unterland-space/badge/Firmware/README.md

# Unterland Badge Firmware

## How To Build
1. Open this folder in VS Code
1. "Just use PlatformIO"

## How To Upload
1. Connect badge to PC (either USB-C port is fine)
1. Turn off power switch (SW3, beside right USB port)
1. Hold right button
1. Turn on power switch
1. => Badge is now in USB ISP mode
1. Use WCH ISP Tool to upload firmware
