unterland-space/badge/PCB/Badge_Top/jlcpcb/production_files/BOM-Badge_Top.csv

Comment | Designator | Footprint | LCSC
100n | C1,C10,C11,C12,C13,C14,C2,C3,C4,C5,C6,C7,C8,C9 | C_0402_1005Metric | C1525
SK6805 | D1,D10,D11,D12,D13,D14,D2,D3,D4,D5,D6,D7,D8,D9 | SK6805SIDE-G-001 | C2909060
Conn_01x01 | J1,J2,J3,J4,J5,J6 | Mounting_Wuerth_WA-SMSI-M2_H7mm_9774070243 | C2916355
