unterland-space/badge/PCB/Badge_Top/Badge_Top.step

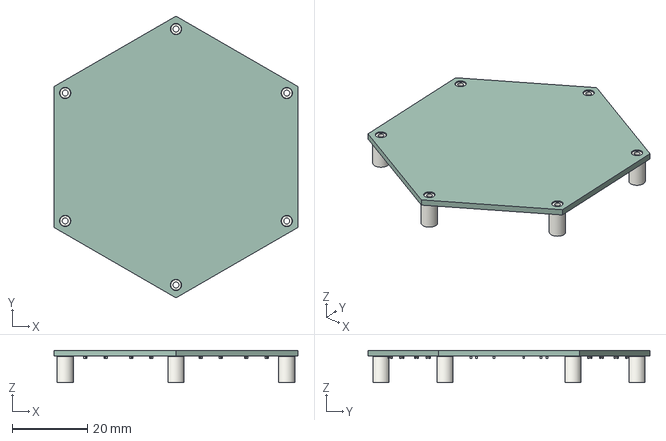
[picture p5: CAD file, 2023-07-29]
PCB/Badge_Top/Badge_Top.step
65.0 x 75.0 x 8.64 mm
Badge_Top PCB
