unterland-space/badge/PCB/Badge_Top/schematic.pdf

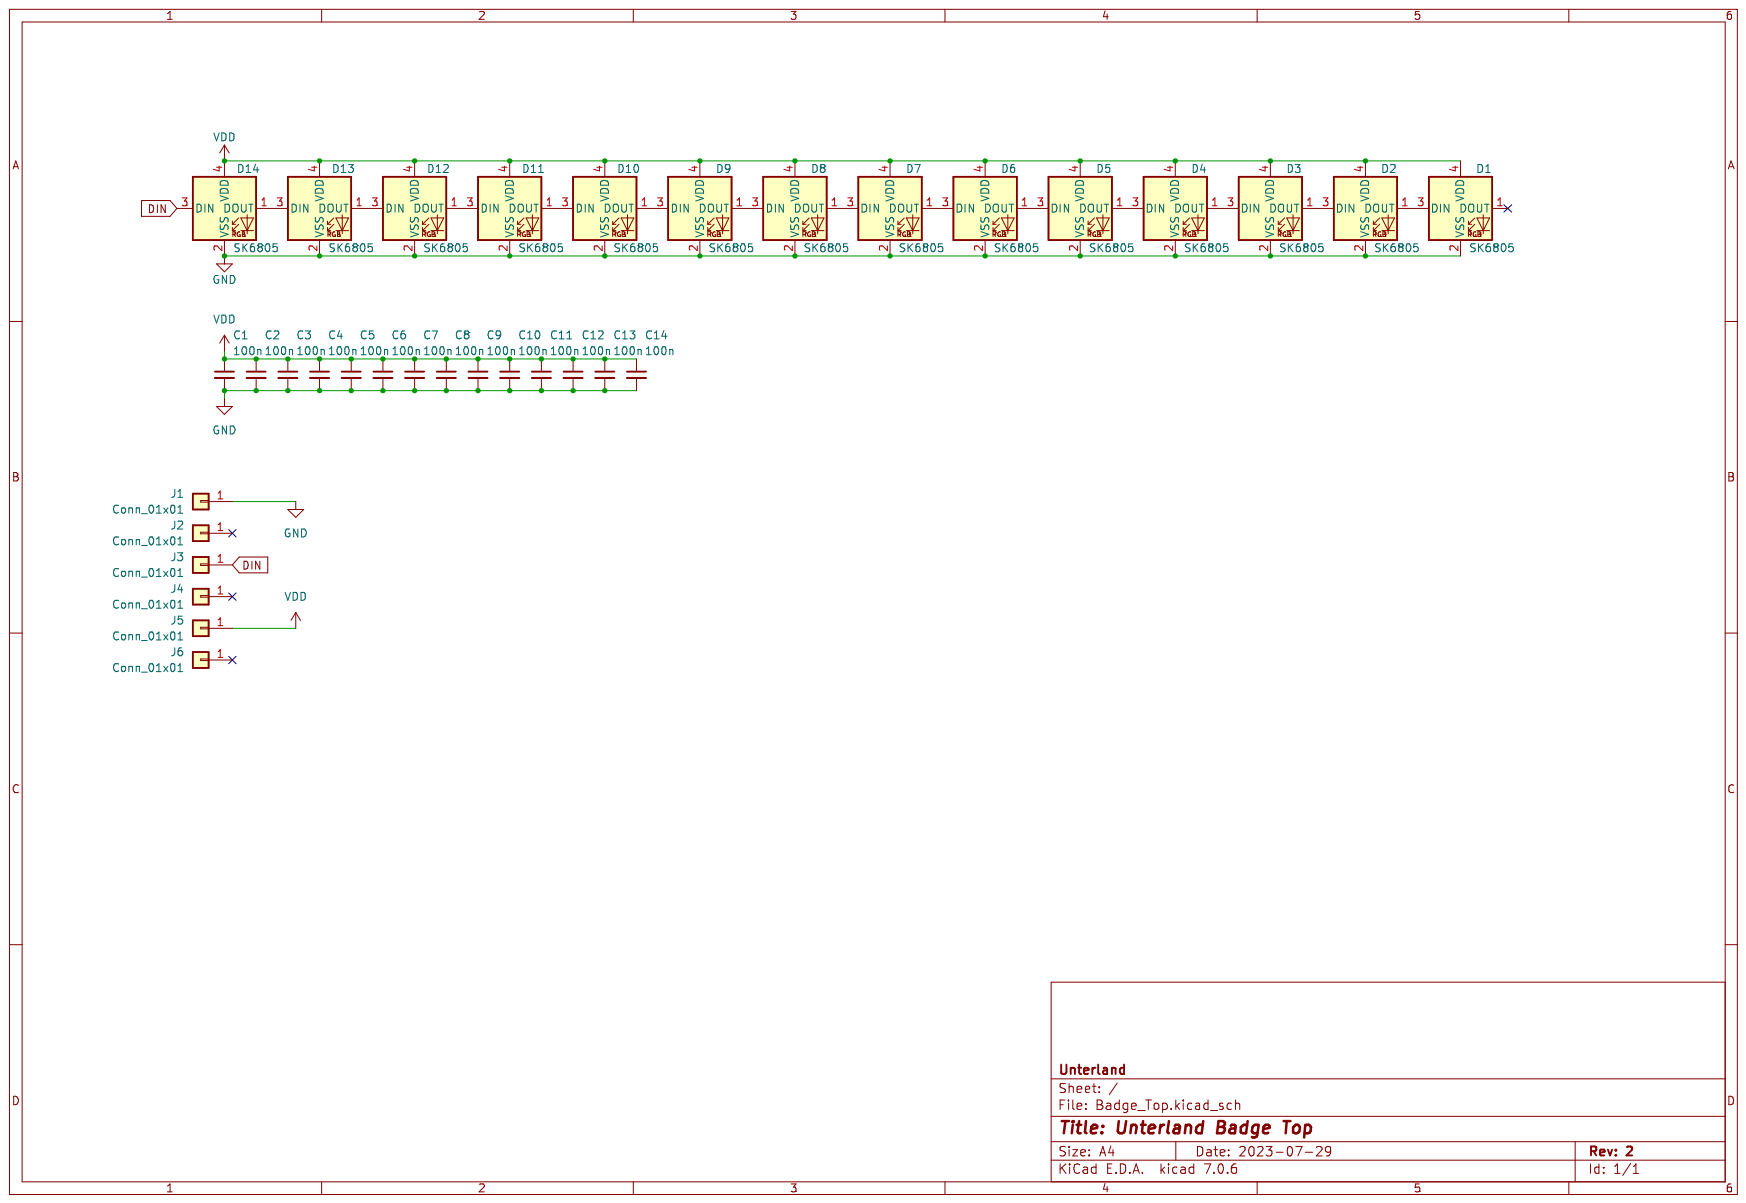
[picture p10: page 1]
