unterland-space/badge/PCB/Badge_Top/Badge_Top.kicad_pcb

## KiCad design PCB/Badge_Top/Badge_Top.kicad_pcb (2023-07-29)

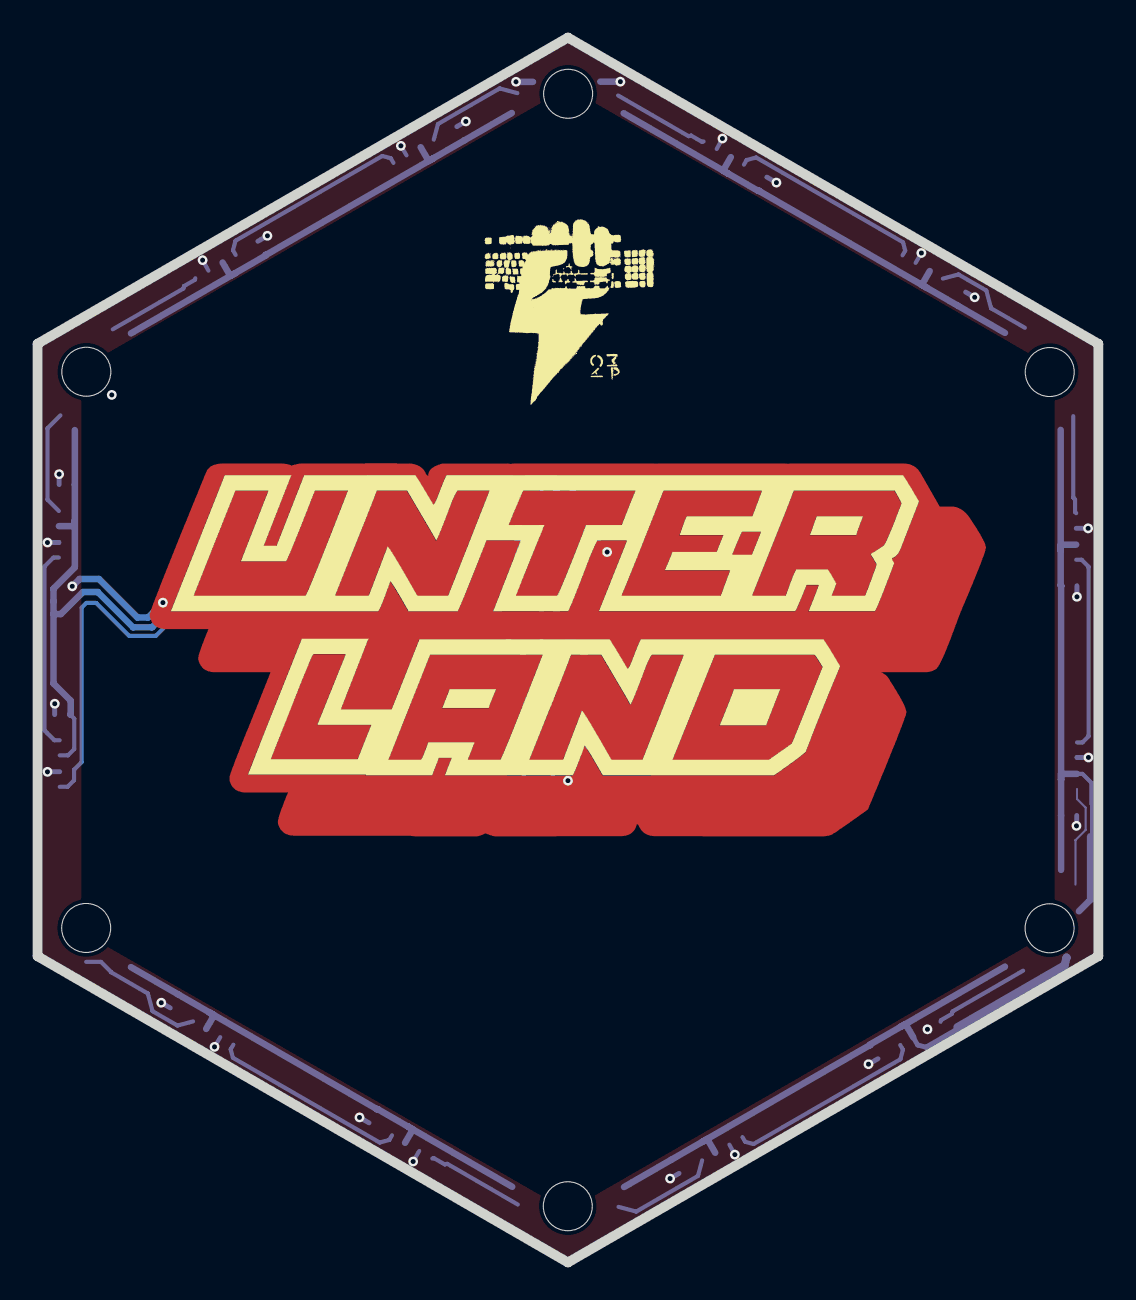
[picture p11: board Badge_Top.kicad_pcb from above]

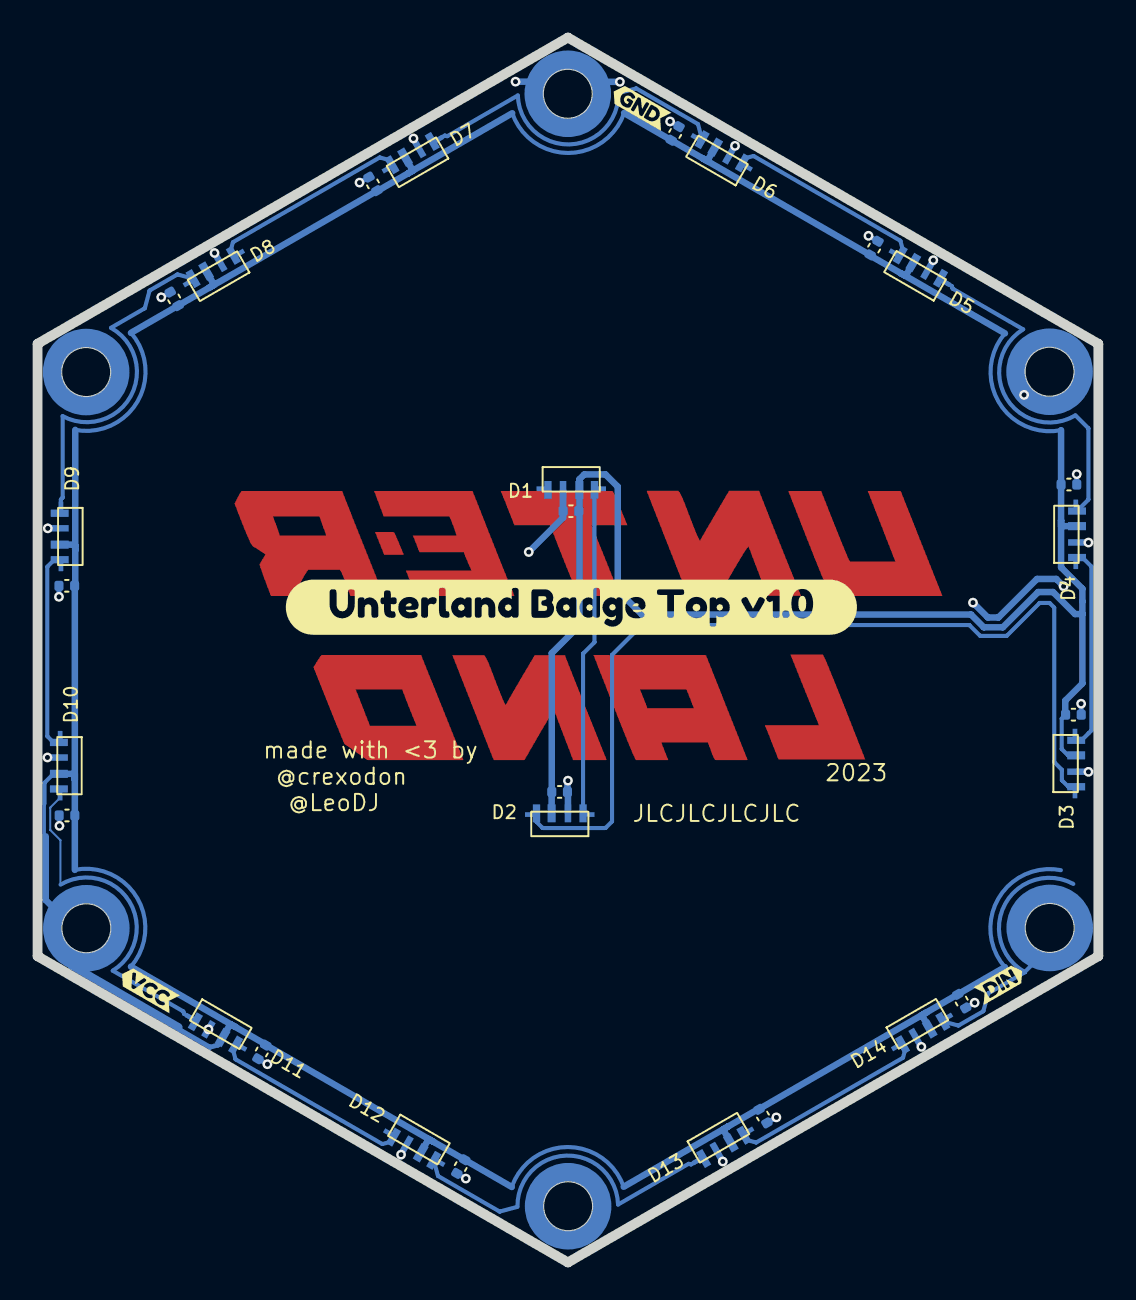
[picture p12: board Badge_Top.kicad_pcb from below]

Board: 2 copper layers, 65.0 x 75.0 mm, 48 parts (38 on the bottom side), 16 nets.

Parts:
1, 2, 3, 4, 5: 9966cd8a-fa79-43c1-83f9-02636052551b
6, 7, 8, 9, 10: 2488e693-1bf8-4f98-9257-4c9c6a257d6e
C1, C2, C3, C4, C5, C6, C7, C8, C9, C10, C11, C12, C13, C14: 100n; C_0402_1005Metric
D1, D2, D3, D4, D5, D6, D7, D8, D9, D10, D11, D12, D13, D14: SK6805; SK6805SIDE-G-001
J1, J2, J3, J4, J5, J6: Conn_01x01; Mounting_Wuerth_WA-SMSI-M2_H7mm_9774070243
kibuzzard-64BC5FAA: G***; kibuzzard-64BC5FAA
kibuzzard-64BC6378: G***; kibuzzard-64BC6378
kibuzzard-64BC6382: G***; kibuzzard-64BC6382
kibuzzard-64BC6413: G***; kibuzzard-64BC6413

Connections:
DIN: D14.3 (DIN), J3.1
GND: C1.2, C2.2, C3.2, C4.2, C5.2, C6.2, C7.2, C8.2, C9.2, C10.2, C11.2, C12.2, C13.2, C14.2, D1.2 (VSS), D2.2 (VSS), D3.2 (VSS), D4.2 (VSS), D5.2 (VSS), D6.2 (VSS), D7.2 (VSS), D8.2 (VSS), D9.2 (VSS), D10.2 (VSS), D11.2 (VSS), D12.2 (VSS), D13.2 (VSS), D14.2 (VSS), J1.1
unnamed: D1.3 (DIN), D2.1 (DOUT)
unnamed: D2.3 (DIN), D3.1 (DOUT)
unnamed: D3.3 (DIN), D4.1 (DOUT)
unnamed: 5.1, D4.3 (DIN), D5.1 (DOUT)
unnamed: D5.3 (DIN), D6.1 (DOUT)
unnamed: 4.1, D6.3 (DIN), D7.1 (DOUT)
unnamed: D7.3 (DIN), D8.1 (DOUT)
unnamed: 3.1, D8.3 (DIN), D9.1 (DOUT)
unnamed: 2.1, D10.3 (DIN), D11.1 (DOUT)
unnamed: D9.3 (DIN), D10.1 (DOUT)
unnamed: D11.3 (DIN), D12.1 (DOUT)
unnamed: 1.1, D12.3 (DIN), D13.1 (DOUT)
unnamed: D13.3 (DIN), D14.1 (DOUT)
VDD: 6.1, 7.1, 8.1, 9.1, 10.1, C1.1, C2.1, C3.1, C4.1, C5.1, C6.1, C7.1, C8.1, C9.1, C10.1, C11.1, C12.1, C13.1, C14.1, D1.4 (VDD), D2.4 (VDD), D3.4 (VDD), D4.4 (VDD), D5.4 (VDD), D6.4 (VDD), D7.4 (VDD), D8.4 (VDD), D9.4 (VDD), D10.4 (VDD), D11.4 (VDD), D12.4 (VDD), D13.4 (VDD), D14.4 (VDD), J5.1
