unterland-space/badge/PCB/Badge_Bottom/Badge_Bottom.kicad_pcb

## KiCad design PCB/Badge_Bottom/Badge_Bottom.kicad_pcb (2023-07-23)

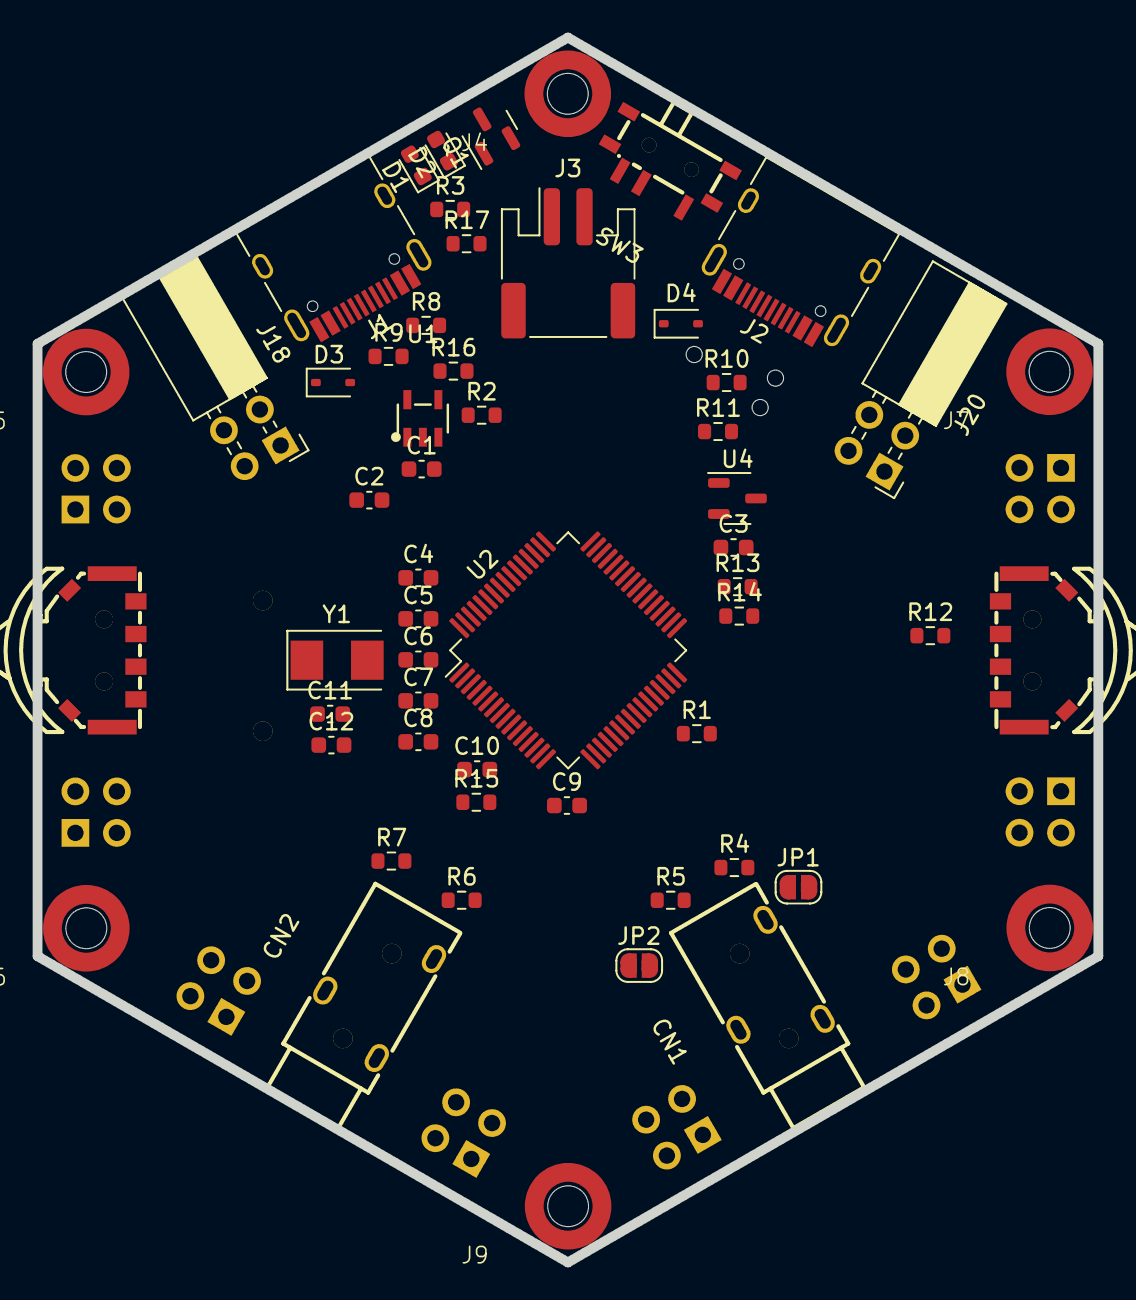
[picture p13: board Badge_Bottom.kicad_pcb from above]

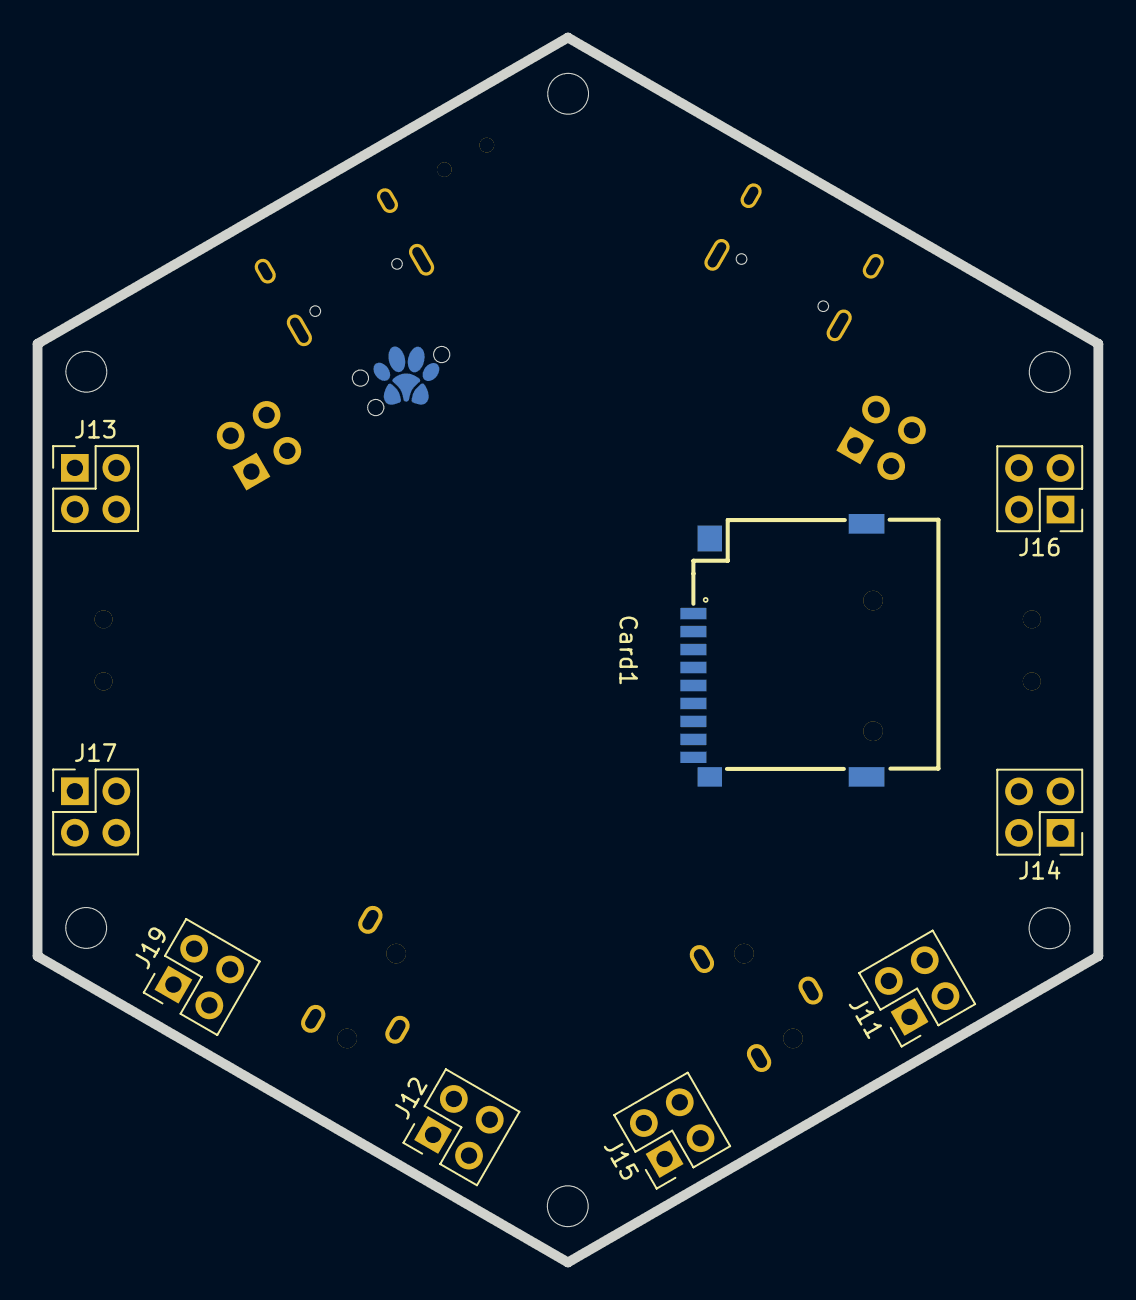
[picture p14: board Badge_Bottom.kicad_pcb from below]

Board: 2 copper layers, 65.0 x 75.0 mm, 66 parts (10 on the bottom side), 70 nets, no tracks yet.

Parts:
C1, C2, C3: 1u; C_0603_1608Metric
C4, C5, C6, C7, C8, C9, C10: 0.1u; C_0603_1608Metric
C11, C12: 20p; C_0603_1608Metric
CN1: JACK_IN; AUDIO-TH_HOOYA_PJ-320
CN2: JACK_OUT; AUDIO-TH_HOOYA_PJ-320
Card1: MicroSD; TF-SMD_TF-PUSH
D1: CHG; LED_0603_1608Metric
D2: USER; LED_0603_1608Metric
D3, D4: 1N5819; D_SOD-323
J1: USB_FS; USB_C_Receptacle_HRO_TYPE-C-31-M-12
J2: USB_HS; USB_C_Receptacle_HRO_TYPE-C-31-M-12
J3: BAT; JST_PH_S2B-PH-SM4-TB_1x02-1MP_P2.00mm_Horizontal
J4, J6, J8: Nylon Screw; Standoff_Pad_M2
J5, J7, J9: Metal Screw; Standoff_Pad_M2
J10: Debug; Paw-Connect_RevB_TC2030-IDC-NL_2x03_P1.27mm_Vertical
J11, J19: Power; PinHeader_2x02_P2.54mm_Vertical
J12, J13, J14, J15, J16, J17: GPIO; PinHeader_2x02_P2.54mm_Vertical
J18: SAO; PinSocket_2x02_P2.54mm_Horizontal
J20: Debug; PinSocket_2x02_P2.54mm_Horizontal
JP1, JP2: SolderJumper_2_Open; SolderJumper-2_P1.3mm_Open_RoundedPad1.0x1.5mm
Q1: AO3400A; SOT-23
R1, R12, R15, R16: 10k; R_0603_1608Metric
R2: 1.65k; R_0603_1608Metric
R3: 330; R_0603_1608Metric
R4, R5, R6, R7: 100; R_0603_1608Metric
R8, R9, R10, R11: 5k1; R_0603_1608Metric
R13, R14: 1M; R_0603_1608Metric
R17: 1k; R_0603_1608Metric
SW1, SW2: TM-2024A; SW-SMD_TM-2024A
SW3: MSK12C02-HB; SW-TH_MSK12C02-HB-1
U1: TP4054; SOT-23-5_L3.0-W1.7-P0.95-LS2.8-BL
U2: CH32V305RBT6; LQFP-64_10x10mm_P0.5mm
U4: XC6206PxxxMR; SOT-23-3
Y1: 8M; Crystal_SMD_5032-2Pin_5.0x3.2mm

Connections:
+3V3: C2.2, C4.1, C5.1, C6.2, C7.1, C8.1, Card1.4 (VDD), J10.1, J11.1, J11.2, J18.1, J19.1, R15.2, R16.1, R17.2, SW1.4, SW2.4, U2.13 (VDDA), U2.19 (VDD), U2.32 (VIO), U2.48 (VDD), U2.64 (VIO), U4.2 (VO)
+BATT: J3.1, SW3.1, U1.3 (BAT)
BOOT0: R12.2, SW1.3, U2.29 (PB10), U2.60 (BOOT0)
GND: C1.1, C2.1, C3.1, C4.2, C5.2, C6.1, C7.2, C8.2, C9.2, C10.1, C11.1, C12.1, CN1.3, CN2.3, Card1.6 (VSS), Card1.10, Card1.11, Card1.12, Card1.13, J1.A1 (GND), J1.A12 (GND), J1.B1 (GND), J1.B12 (GND), J1.S1 (SHIELD), J2.A1 (GND), J2.A12 (GND), J2.B1 (GND), J2.B12 (GND), J2.S1 (SHIELD), J3.2, J10.5, J11.3, J11.4, J18.3, J19.3, J19.4, J20.1, Q1.2 (S), R1.2, R2.2, R8.2, R9.2, R10.2, R11.2, R12.1, R14.1, SW3.4, U1.2 (GND), U2.12 (VSSA), U2.18 (VSS), U2.31 (VSS), U2.47 (VSS), U2.63 (VSS), U4.1 (GND)
NRST: C10.2, J10.3, J20.3, R15.1, U2.7 (NRST)
unnamed: CN1.2, R5.2
unnamed: CN1.4, R4.2
unnamed: CN2.2, R7.2
unnamed: CN2.4, R6.2
unnamed: D1.1 (K), R3.1
unnamed: D2.2 (A), U2.23 (PA7)
unnamed: D2.1 (K), R17.1
unnamed: D3.2 (A), J1.A4 (VBUS), J1.A9 (VBUS), J1.B4 (VBUS), J1.B9 (VBUS)
unnamed: D4.2 (A), J2.A4 (VBUS), J2.A9 (VBUS), J2.B4 (VBUS), J2.B9 (VBUS)
unnamed: J1.A5 (CC1), R8.1
unnamed: J1.B5 (CC2), R9.1
unnamed: J2.A5 (CC1), R10.1
unnamed: J2.B5 (CC2), R11.1
unnamed: J4.1, Q1.3 (D)
unnamed: R3.2, U1.1 (CHRG)
unnamed: R2.1, U1.5 (PROG)
unnamed: R1.1, U2.28 (BOOT1/PB2)
unnamed: C11.2, U2.5 (OSC_IN), Y1.2
unnamed: C12.2, U2.6 (OSC_OUT), Y1.1
PA0-GPIO: J17.1, U2.14 (WAKEUP/PA0)
PA1-ADC_IN1: C9.1, R13.1, R14.2, U2.15 (PA1)
PA2-ADC_IN2/USART2_TX: JP2.2 (B), R5.1, U2.16 (PA2)
PA3-ADC_IN_3/USART2_RX: JP1.2 (B), R4.1, U2.17 (PA3)
PA4-DAC1: R6.1, U2.20 (PA4), U2.42 (PA9)
PA6-LEDFET: Q1.1 (G), R16.2, U2.22 (PA6)
PA8-TIM1: J6.1, U2.41 (PA8)
PA10-USART1_RX: R7.1, U2.21 (PA5), U2.43 (PA10)
PA11-USBFS_DM: J1.A7 (D-), J1.B7 (D-), U2.44 (PA11)
PA12-USBFS_DP: J1.A6 (D+), J1.B6 (D+), U2.45 (PA12)
PA13-SWD: J10.2, J20.2, U2.46 (PA13)
PA14-SWCLK: J10.4, J20.4, U2.49 (PA14)
PA15-SPI1_NSS: J16.4, U2.50 (PA15)
PB0-UART4_TX: JP1.1 (A), U2.26 (PB0)
PB1-UART4_RX: JP2.1 (A), U2.27 (PB1)
PB3-SPI1_SCK: J16.1, U2.55 (PB3)
PB4-SPI1_MISO: J16.2, U2.56 (PB4)
PB5-SPI1_MOSI: J16.3, U2.57 (PB5)
PB6-USBHS_DM: J2.A7 (D-), J2.B7 (D-), U2.58 (PB6)
PB7-USBHS_DP: J2.A6 (D+), J2.B6 (D+), U2.59 (PB7)
PB8-I2C_SCL: J17.4, J18.4, U2.61 (PB8)
PB9-I2C_SDA: J17.2, J18.2, U2.62 (PB9)
PB11-BTNR_UP: SW1.1, U2.30 (PB11)
PB12-BNTR_DOWN: SW1.2, U2.33 (PB12)
PB13-BTNL-BTN: SW2.3, U2.34 (PB13)
PB14-BTNL_UP: SW2.2, U2.35 (PB14)
PB15-BTNL_DOWN: SW2.1, U2.36 (PB15)
PC0-GPIO: J12.1, U2.8 (PC0)
PC1-GPIO: J12.2, U2.9 (PC1)
PC2-GPIO: J12.3, U2.10 (PC2)
PC3-GPIO: J12.4, U2.11 (PC3)
PC4-GPIO: J13.1, U2.24 (PC4)
PC5-GPIO: J13.2, U2.25 (PC5)
PC6-GPIO: J13.3, U2.37 (PC6)
PC7-GPIO: J13.4, U2.38 (PC7)
PC8-SDIO_D0: Card1.7 (DAT0), J14.1, U2.39 (PC8)
PC9-SDIO_D1: Card1.8 (DAT1), J14.2, U2.40 (PC9)
PC10-SDIO_D2: Card1.1 (DAT2), J14.3, U2.51 (PC10)
PC11-SDIO_D3: Card1.2 (CD/DAT3), J14.4, U2.52 (PC11)
PC12-SDIO_CLK: Card1.5 (CLX), J15.1, U2.53 (PC12)
PC13-SDIO_CD: J15.2, U2.2 (PC13/TAMPER-RTC)
PC14-GPIO: J15.3, U2.3 (PC14/OSC32_IN)
PC15-GPIO: J15.4, U2.4 (PC15/OSC32_OUT)
PD2-SDIO_CMD: Card1.3 (CMD), J17.3, U2.54 (PD2)
VBUS: C1.2, D1.2 (A), D3.1 (K), D4.1 (K), U1.4 (VCC)
VDD: C3.2, J8.1, J19.2, R13.2, SW3.2, U4.3 (VI)
