unterland-space/badge/Firmware/src/util.h

#include <ch32v30x.h>
#include <stdio.h>

// better delay functions, that keep the SysTick counter running 
// (just make sure not to call the "official" Delay_Ms functions)
void SysTickInit();
uint32_t millis();
uint32_t micros();
void delay(uint32_t ms);
void delay_us(uint32_t us);

uint64_t getUID();

void printHex(uint8_t* buf, uint16_t size);
