unterland-space/badge/(commit log)

2023-07-18 added symbols and footprints
    [Badge_Bottom.kicad_pcb, Badge_Bottom.kicad_sch, power.kicad_sch]
2023-07-18 Added todo for bottom badge
    [Badge_Bottom.kicad_sch]
2023-07-18 do layout of top PCB, generated preliminary gerbers
    [BOM-Badge_Top.csv, Badge_Top.kicad_pcb, Badge_Top.kicad_sch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]
2023-07-21 Added pcb outline from Badge_Top, added todos in pcb file
    [Badge_Bottom.kicad_pcb, Badge_Bottom.kicad_sch]
2023-07-22 Added new page for IO, added new components, added JLC parts, fixed PCB standoffs to be pads and modified concept of PCB (dual usbc)
    [Badge_Bottom.kicad_pcb, Badge_Bottom.kicad_sch, io.kicad_sch, power.kicad_sch]
2023-07-22 better silkscreen, remove DOUT
    [BOM-Badge_Top.csv, Badge_Top.kicad_pcb, Badge_Top.kicad_sch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]
2023-07-23 finished schematic and added jlc parts
    [BOM-Badge_Bottom.csv, Badge_Bottom.kicad_sch, power.kicad_sch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]
2023-07-23 saved files
    [Badge_Bottom.kicad_pcb]
2023-07-29 finised pcb layout
    [Badge_Bottom.kicad_sch, Badge_Top.kicad_pcb, Badge_Top.step, badgelink.kicad_sch, io.kicad_sch, power.kicad_sch]
2023-07-29 added all missing jlcpcb numbers, order ready
    [BOM-Badge_Bottom.csv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]
2023-07-29 Added docs and readme, ordered PCBs at JLC
    [Badge_Bottom.kicad_sch, Badge_Top.kicad_sch, badgelink.kicad_sch, io.kicad_sch, power.kicad_sch]
2023-08-19 copy LED "library" from LEDCollar
2023-08-19 modify LED "library" for CH32V3xx
